orangecrust/gullwing/README.md

# Gullwing Keyboard
Basic layout based on the [re-gret](https://github.com/rschenk/re-gret).
