orangecrust/gullwing/bom.ods

part | ppu | qty | total | notes | seller | link
pcb |  |  | 0 | Pcba – exclude mcu, sockets | jlcpcb
rp2040 zero | $20.00 | 1 | $20.00 | 3 ea | amazon | https://www.amazon.com/RP2040-Zero-High-Performance-Microcontroller-Castellated-Boards-3pcs/dp/B0B2ZFGSMD
ffc halves | $2.95 | 2 | $5.90 |  | mouser | https://www.mouser.com/ProductDetail/Wurth-Elektronik/687614100002
touch module | $30.00 | 1 | $30.00 |  | holykeebs | https://holykeebs.com/products/touchpad-module?variant=49754990936354
ffc touch | $1.19 | 1 | $1.19 | 6-pin, 0.5mm pitch | mouser | https://www.mouser.com/ProductDetail/GCT/05-06-D-0030-A-4-06-4-T
xxx gauge wire |  |  | 0 | TODO – gauge? | mouser
tactile switches (black cloud) | $6.50 | 4 | $26.00 | 10 ea | holykeebs | https://holykeebs.com/products/kailh-choc-v2-pom-switches?variant=49253846843682
linear switches (saker) | $17.19 | 2 | $34.38 | 20 ea | amazon | https://www.amazon.com/Low-Profile-Ultra-Short-Acuation-Mechanical-Keyboard/dp/B0F8H64GSD?th=1
keycaps | $7.21 | 3 | $21.63 | 18 ea | tai hao | https://shop.tai-hao.com/products/thcs-blank-keycaps
bumpons | $0.09 | 30 | $2.82 | > 2.1 mm | mouser | https://www.mouser.com/ProductDetail/3M-Electronic-Specialty/SJ-5302-CLEAR
hotswap sockets | $2.50 | 9 | $22.50 | 10 ea | holykeebs | https://holykeebs.com/products/kailh-choc-hotswap-sockets?variant=44532144079138
 |  |  | 164.42
