orangecrust/gullwing/pcb/gullwing/gullwing.kicad_pcb

## KiCad design pcb/gullwing/gullwing.kicad_pcb (2025-09-15)

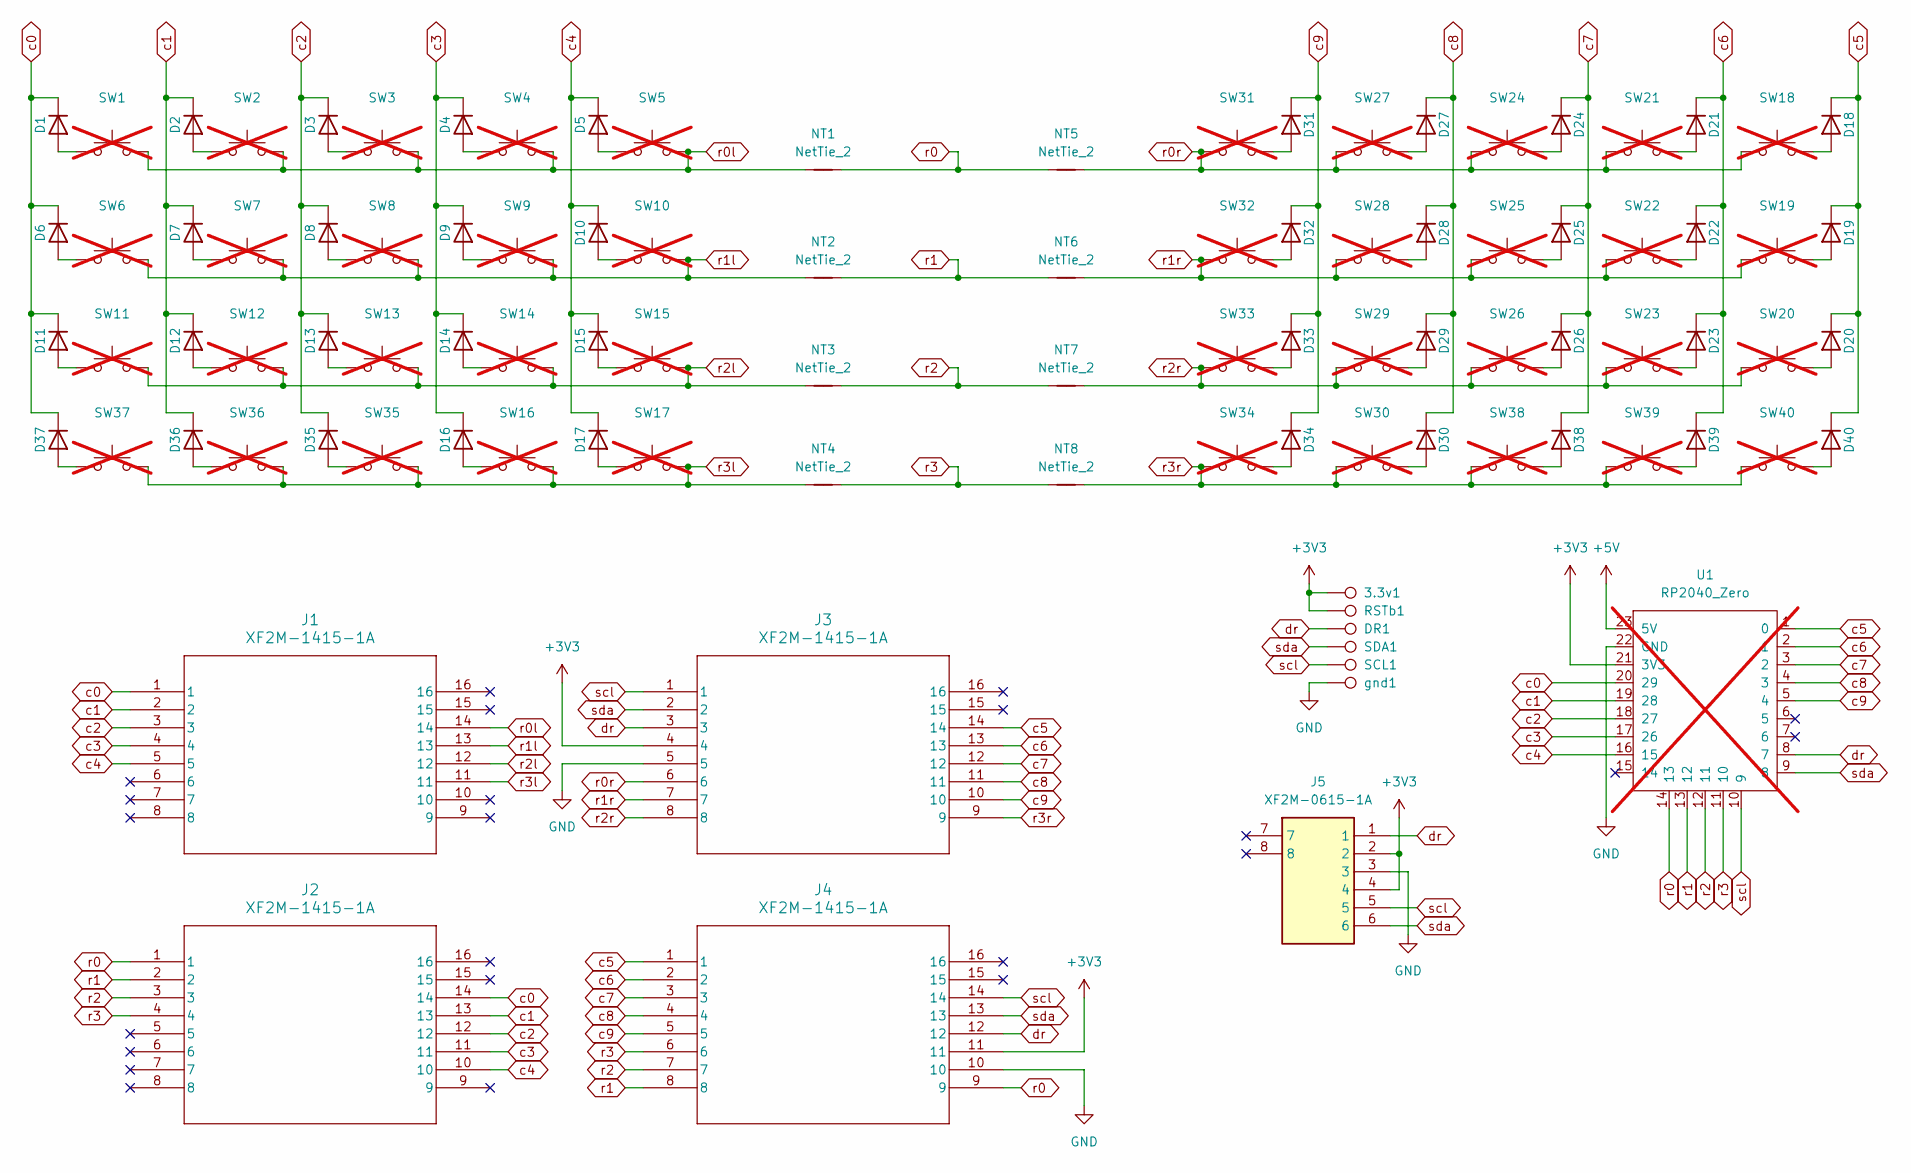
[picture p1: schematic gullwing.kicad_sch]

Parts:
3.3v1: TestPoint; TestPoint_Pad_1.0x1.0mm
D1, D2, D3, D4, D5, D6, D7, D8, D9, D10, D11, D12, D13, D14, D15, D16, D17, D18, D19, D20, D21, D22, D23, D24, D25, D26, D27, D28, D29, D30, D31, D32, D33, D34, D35, D36, D37, D38, D39, D40: Diode_SOD-123
DR1: TestPoint; TestPoint_Pad_1.0x1.0mm
J1, J2, J3, J4: XF2M-1415-1A; CON14_1X14_DRB_XF2C_TYC
J5: XF2M-0615-1A; XF2M06151A; Mouser Part Number 653-XF2M-0615-1A
NT1, NT2, NT3, NT4, NT5, NT6, NT7, NT8: NetTie_2; NetTie-2_SMD_Pad0.5mm
RSTb1: TestPoint; TestPoint_Pad_1.0x1.0mm
SCL1: TestPoint; TestPoint_Pad_1.0x1.0mm
SDA1: TestPoint; TestPoint_Pad_1.0x1.0mm
SW1, SW2, SW3, SW4, SW5, SW6, SW7, SW8, SW9, SW10, SW11, SW12, SW13, SW14, SW15, SW16, SW17, SW18, SW19, SW20, SW21, SW22, SW23, SW24, SW25, SW26, SW27, SW28, SW29, SW30, SW31, SW32, SW33, SW34, SW35, SW36, SW37, SW38, SW39, SW40: Hotswap_Choc_V1V2_1.00u; not fitted
U1: RP2040_Zero; not fitted
gnd1: TestPoint; TestPoint_Pad_1.0x1.0mm

Connections:
+3V3: 3.3v1.1, J3.4, J4.11, J5.2, J5.4, RSTb1.1, U1.21 (3V3)
+5V: U1.23 (5V)
GND: J3.5, J4.10, J5.3, U1.22 (GND), gnd1.1
unnamed: D1.2 (A), SW1.1
unnamed: D2.2 (A), SW2.1
unnamed: D3.2 (A), SW3.1
unnamed: D4.2 (A), SW4.1
unnamed: D5.2 (A), SW5.1
unnamed: D6.2 (A), SW6.1
unnamed: D7.2 (A), SW7.1
unnamed: D8.2 (A), SW8.1
unnamed: D9.2 (A), SW9.1
unnamed: D10.2 (A), SW10.1
unnamed: D11.2 (A), SW11.1
unnamed: D12.2 (A), SW12.1
unnamed: D13.2 (A), SW13.1
unnamed: D14.2 (A), SW14.1
unnamed: D15.2 (A), SW15.1
unnamed: D16.2 (A), SW16.1
unnamed: D17.2 (A), SW17.1
unnamed: D18.2 (A), SW18.1
unnamed: D19.2 (A), SW19.1
unnamed: D20.2 (A), SW20.1
unnamed: D21.2 (A), SW21.1
unnamed: D22.2 (A), SW22.1
unnamed: D23.2 (A), SW23.1
unnamed: D24.2 (A), SW24.1
unnamed: D25.2 (A), SW25.1
unnamed: D26.2 (A), SW26.1
unnamed: D27.2 (A), SW27.1
unnamed: D28.2 (A), SW28.1
unnamed: D29.2 (A), SW29.1
unnamed: D30.2 (A), SW30.1
unnamed: D31.2 (A), SW31.1
unnamed: D32.2 (A), SW32.1
unnamed: D33.2 (A), SW33.1
unnamed: D34.2 (A), SW34.1
unnamed: D35.2 (A), SW35.1
unnamed: D36.2 (A), SW36.1
unnamed: D37.2 (A), SW37.1
unnamed: D38.2 (A), SW38.1
unnamed: D39.2 (A), SW39.1
unnamed: D40.2 (A), SW40.1
c0: D1.1 (K), D6.1 (K), D11.1 (K), D37.1 (K), J1.1, J2.14, U1.20 (29)
c1: D2.1 (K), D7.1 (K), D12.1 (K), D36.1 (K), J1.2, J2.13, U1.19 (28)
c2: D3.1 (K), D8.1 (K), D13.1 (K), D35.1 (K), J1.3, J2.12, U1.18 (27)
c3: D4.1 (K), D9.1 (K), D14.1 (K), D16.1 (K), J1.4, J2.11, U1.17 (26)
c4: D5.1 (K), D10.1 (K), D15.1 (K), D17.1 (K), J1.5, J2.10, U1.16 (15)
c5: D18.1 (K), D19.1 (K), D20.1 (K), D40.1 (K), J3.14, J4.1, U1.1 (0)
c6: D21.1 (K), D22.1 (K), D23.1 (K), D39.1 (K), J3.13, J4.2, U1.2 (1)
c7: D24.1 (K), D25.1 (K), D26.1 (K), D38.1 (K), J3.12, J4.3, U1.3 (2)
c8: D27.1 (K), D28.1 (K), D29.1 (K), D30.1 (K), J3.11, J4.4, U1.4 (3)
c9: D31.1 (K), D32.1 (K), D33.1 (K), D34.1 (K), J3.10, J4.5, U1.5 (4)
dr: DR1.1, J3.3, J4.12, J5.1, U1.8 (7)
r0: J2.1, J4.9, NT1.2, NT5.1, U1.14 (13)
r0l: J1.14, NT1.1, SW1.2, SW2.2, SW3.2, SW4.2, SW5.2
r0r: J3.6, NT5.2, SW18.2, SW21.2, SW24.2, SW27.2, SW31.2
r1: J2.2, J4.8, NT2.2, NT6.1, U1.13 (12)
r1l: J1.13, NT2.1, SW6.2, SW7.2, SW8.2, SW9.2, SW10.2
r1r: J3.7, NT6.2, SW19.2, SW22.2, SW25.2, SW28.2, SW32.2
r2: J2.3, J4.7, NT3.2, NT7.1, U1.12 (11)
r2l: J1.12, NT3.1, SW11.2, SW12.2, SW13.2, SW14.2, SW15.2
r2r: J3.8, NT7.2, SW20.2, SW23.2, SW26.2, SW29.2, SW33.2
r3: J2.4, J4.6, NT4.2, NT8.1, U1.11 (10)
r3l: J1.11, NT4.1, SW16.2, SW17.2, SW35.2, SW36.2, SW37.2
r3r: J3.9, NT8.2, SW30.2, SW34.2, SW38.2, SW39.2, SW40.2
scl: J3.1, J4.14, J5.5, SCL1.1, U1.10 (9)
sda: J3.2, J4.13, J5.6, SDA1.1, U1.9 (8)

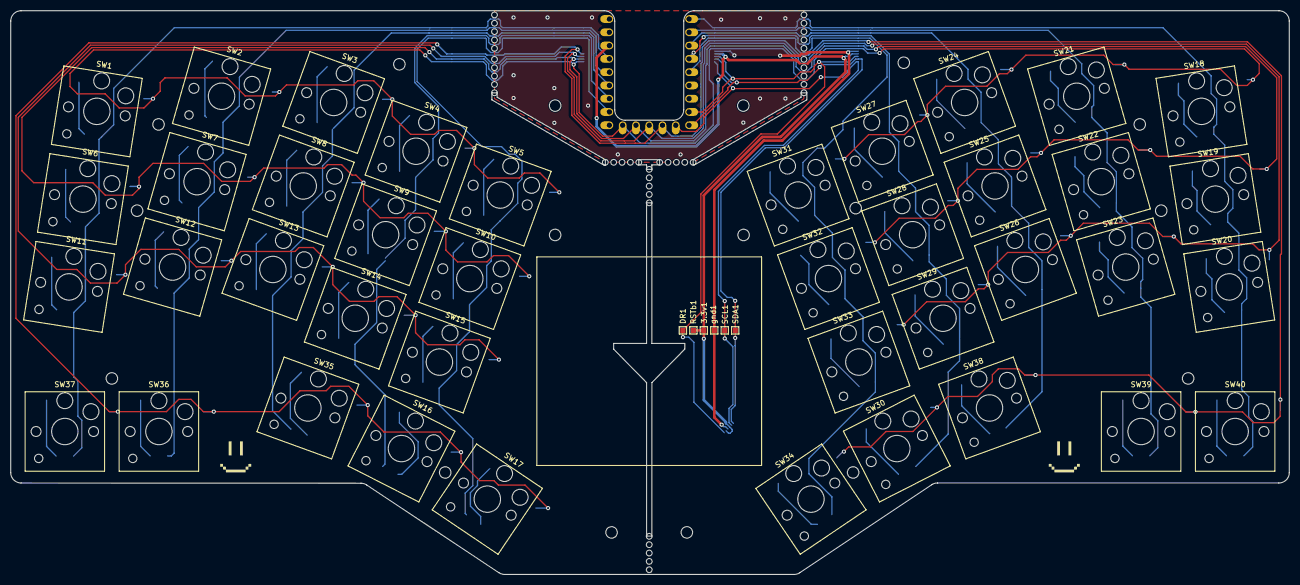
[picture p2: board gullwing.kicad_pcb from above]

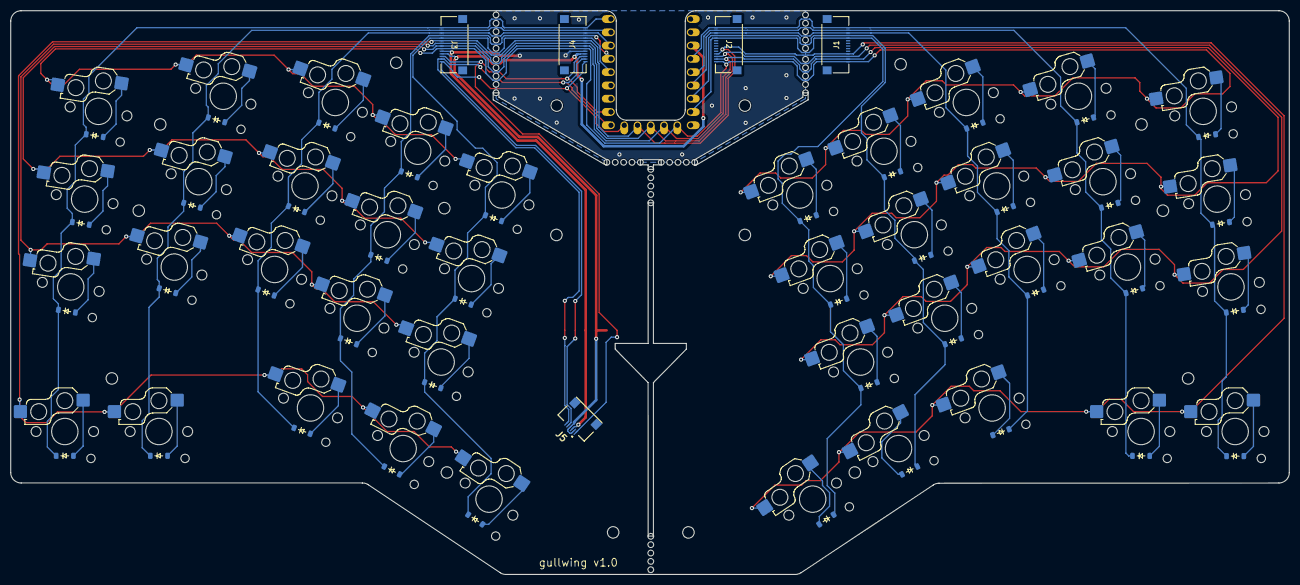
[picture p3: board gullwing.kicad_pcb from below]

Board: 2 copper layers, 244.6 x 107.8 mm, 125 parts (53 on the bottom side), 67 nets.

Other parts of the board:
PAD5, PAD6, PAD7, PAD8, PAD8#2, PAD8#3, PAD8#4, PAD8#5, PAD8#6, PAD8#7, PAD8#8, PAD8#9, PAD8#10, PAD8#11, PAD10, PAD11, PAD12: MountingHole_2.2mm_M2
mb1, mb2, mb2#2, mb2#3, mb2#4, mb2#5, mb3, mb4: Mouse_Bites_5
