orangecrust/gullwing/(commit log)

2025-08-16 basic routing done
    todo:
    touchpad i2c/dr conneciton & routing
    expand horizontally
    [gullwing.kicad_pcb, gullwing.kicad_sch]
2025-08-17 done -- first pass
    [gullwing.kicad_pcb, gullwing.kicad_sch]
2025-08-21 done -- ready for export
    [gullwing.kicad_pcb, gullwing.kicad_sch]
2025-08-21 adding production files
    [bom.csv, designators.csv, positions.csv]
2025-08-21 updating name
    [gullwing.kicad_pcb, gullwing.kicad_sch]
